jpwolfe31/Magnetic-Core-Memory-Demo-Board/Board back.JPG

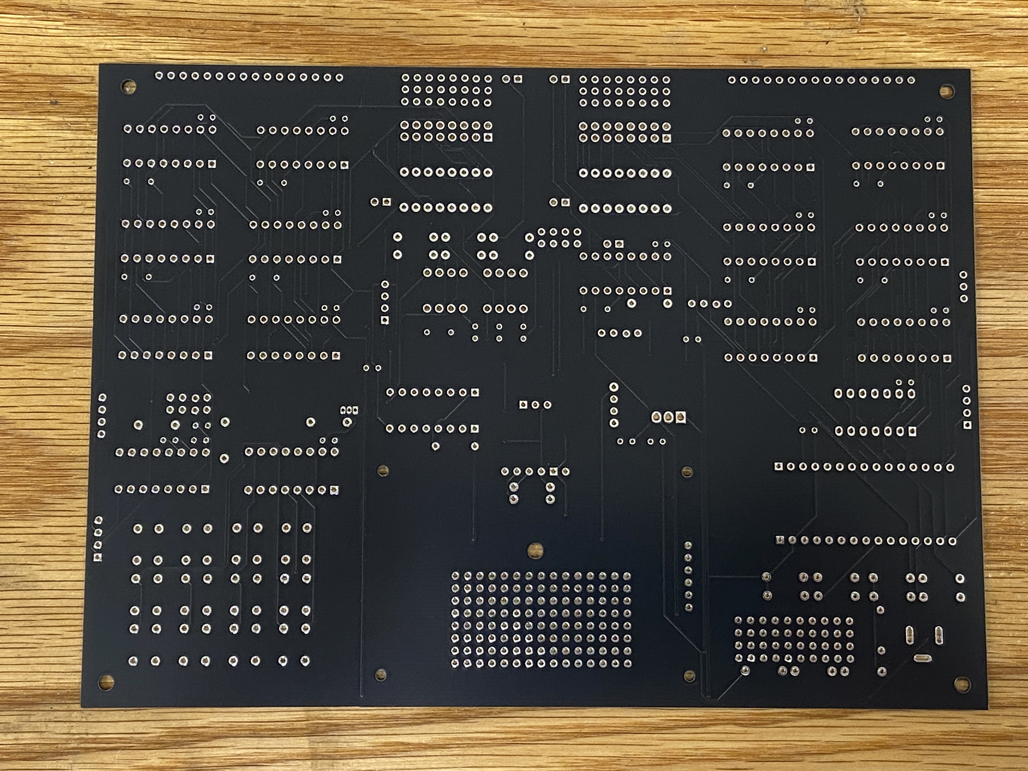
Board back.JPG
