jpwolfe31/Magnetic-Core-Memory-Demo-Board/Board front.JPG

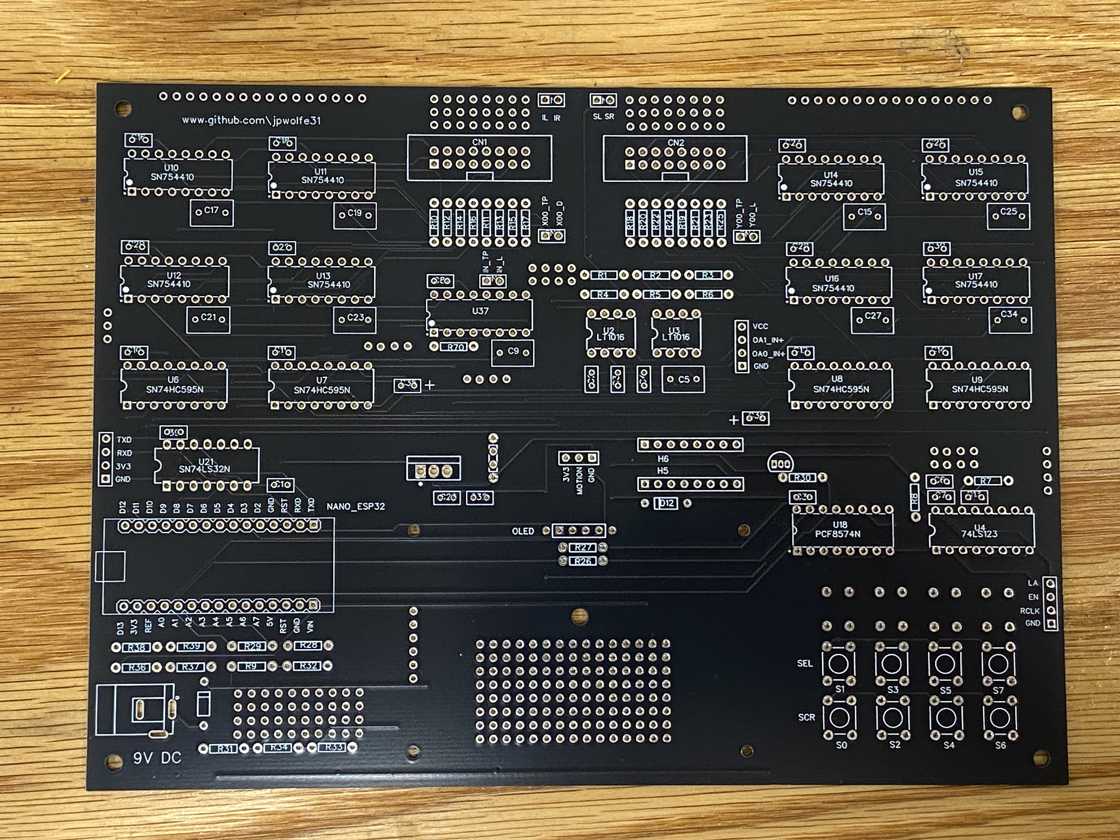
Board front.JPG
