jpwolfe31/Magnetic-Core-Memory-Demo-Board/Note on wrappin x drive lines.pdf

I looked into wrapping the x lines as shown below to reduce the number of x drive chips by one-half (x0 goes to x4, x1 goes to x5, etc.).

___________________________
___________________________
/ | \ | / | \ | / | \ | y1
\ | / | \ | / | \ | / | y0
x0 | x1 | x2 | x3 | x4 | x5 . . .
x0u | - | - | - | x4d
y0r | y0r | y0r | y0r | y0r
id | iu | id | iu | id

current directions at the cores:
r right
l left
u up
| d down

When a 1 is written to x0y0 as shown in the chart above, x4y1-7 will flip if the inhibit current equals the x4 current. Therefore, with the wrap, the inhibit current must be significantly less than the x current. I experimented with dierent current values, but could not achieve ultra reliable writes and reads, so I chose not to wrap the x lines. This choice was made easier once I had decided to limit the project to an 8 by 8 matrix of 64 bits.
