jpwolfe31/Magnetic-Core-Memory-Demo-Board/oscilloscope waveforms.pdf

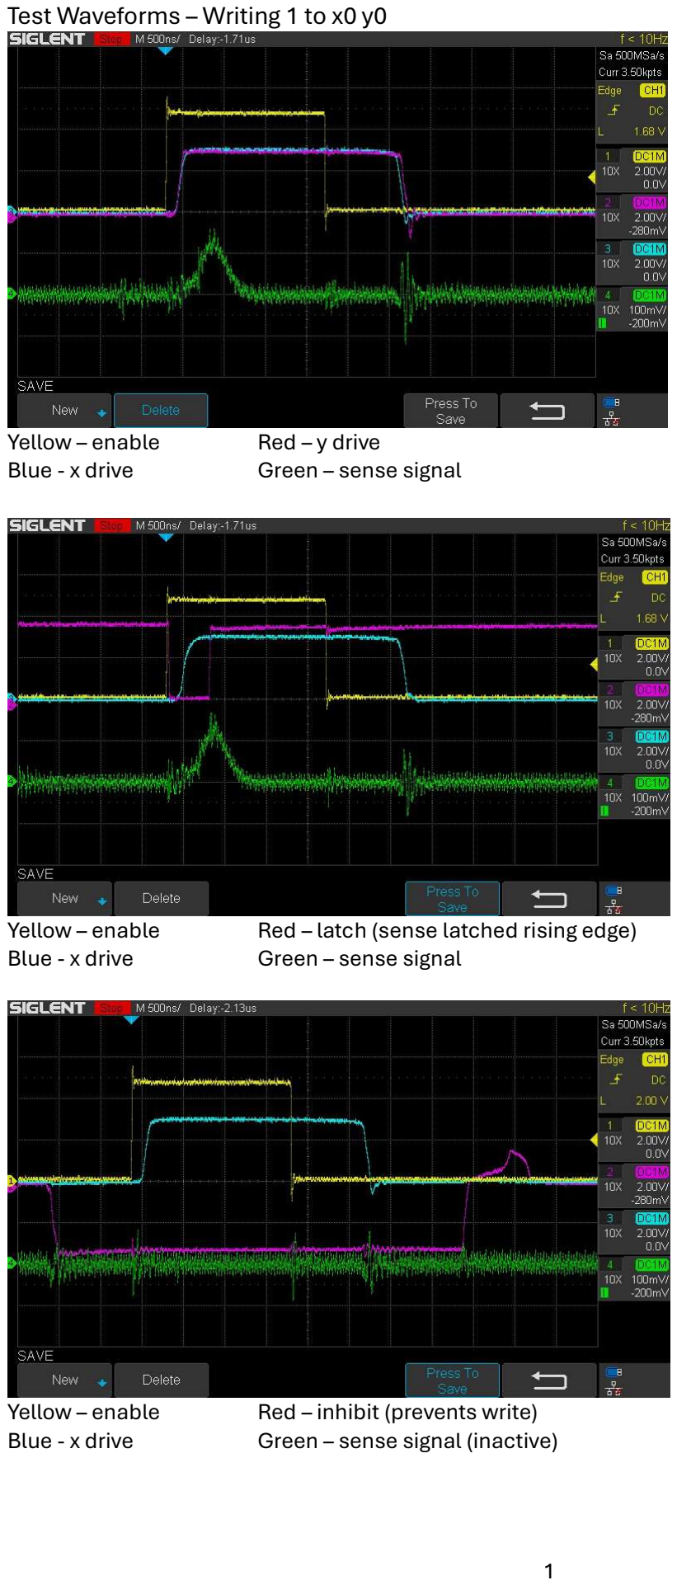
[picture p3: page 1]

1

Test Waveforms – Writing 1 to x0 y0

Yellow – enable | Red – y drive
Blue - x drive | Green – sense signal
Yellow – enable | Red – latch (sense latched rising edge)
Blue - x drive | Green – sense signal
Yellow – enable | Red – inhibit (prevents write)
Blue - x drive | Green – sense signal (inactive)

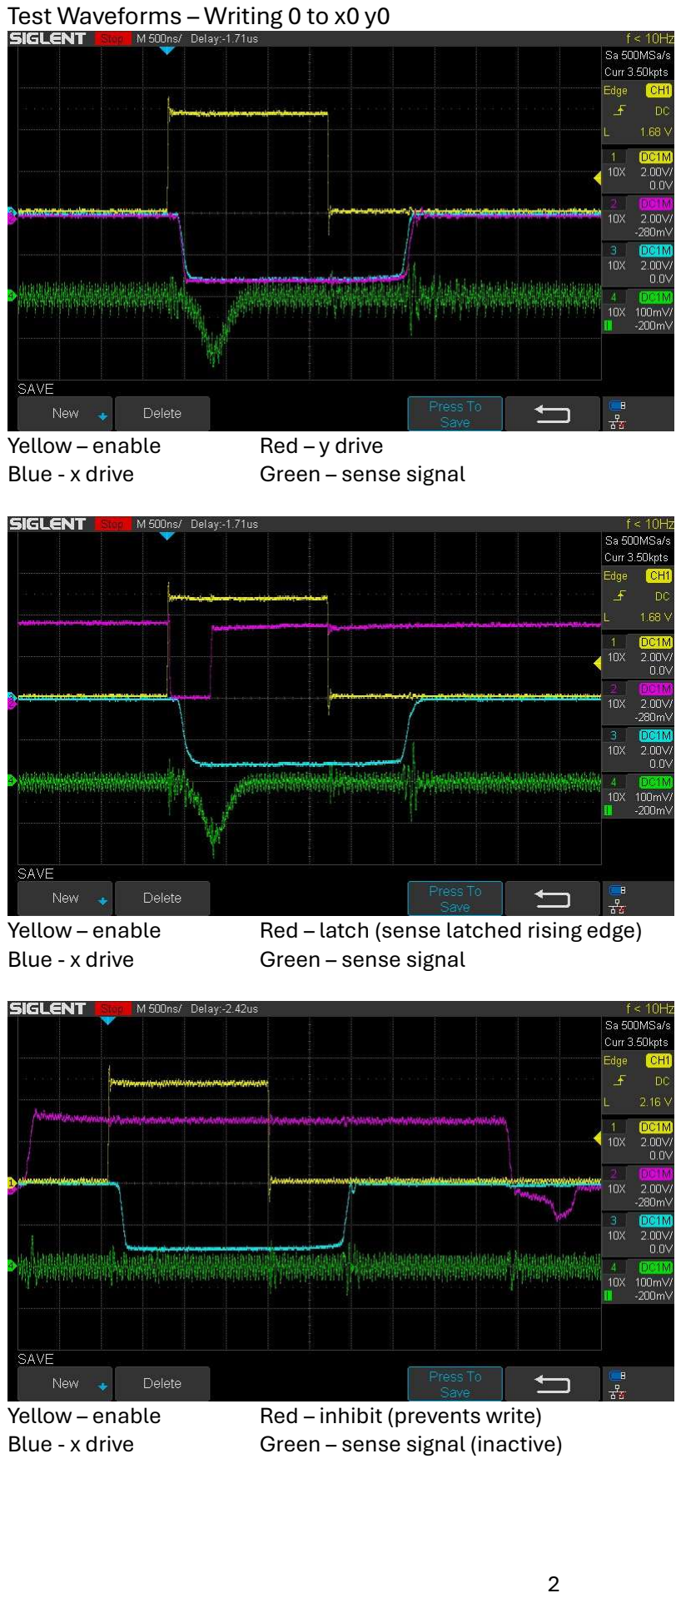
[picture p4: page 2]

2

Test Waveforms – Writing 0 to x0 y0

Yellow – enable | Red – y drive
Blue - x drive | Green – sense signal
Yellow – enable | Red – latch (sense latched rising edge)
Blue - x drive | Green – sense signal
Yellow – enable | Red – inhibit (prevents write)
Blue - x drive | Green – sense signal (inactive)

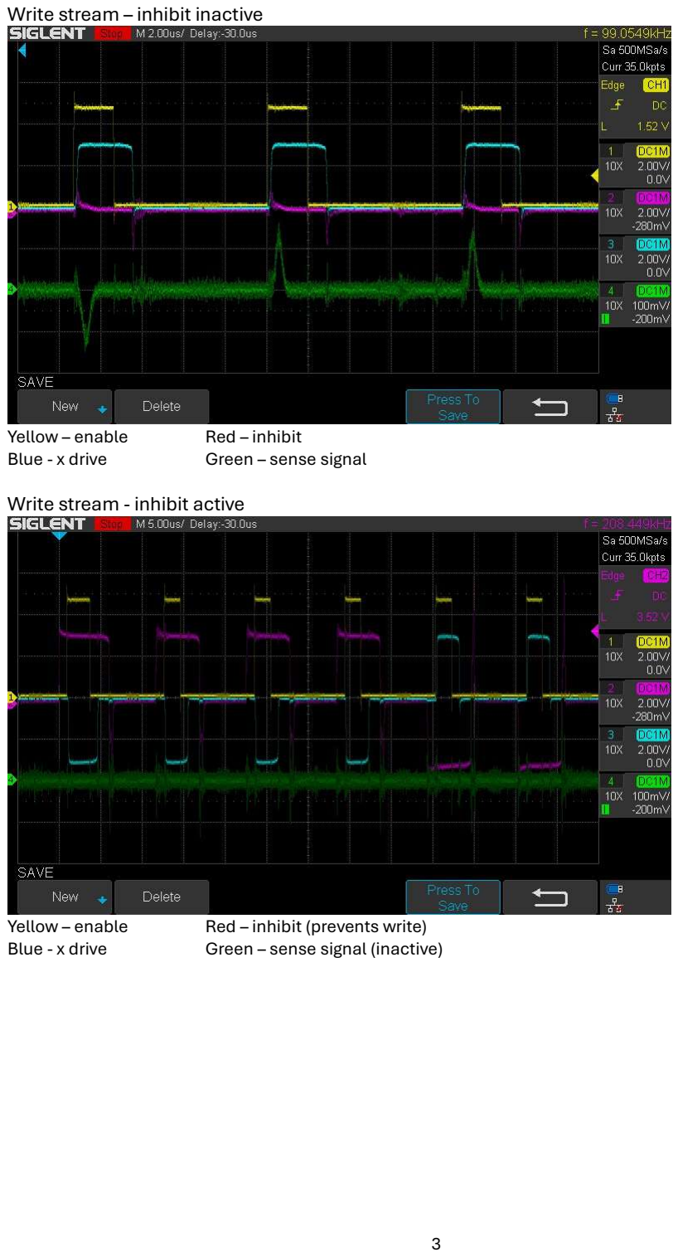
[picture p5: page 3]

3

Write stream – inhibit inactive

Yellow – enable | Red – inhibit
Blue - x drive | Green – sense signal

Write stream - inhibit active

Yellow – enable | Red – inhibit (prevents write)
Blue - x drive | Green – sense signal (inactive)
