jpwolfe31/Magnetic-Core-Memory-Demo-Board/10M count.JPG

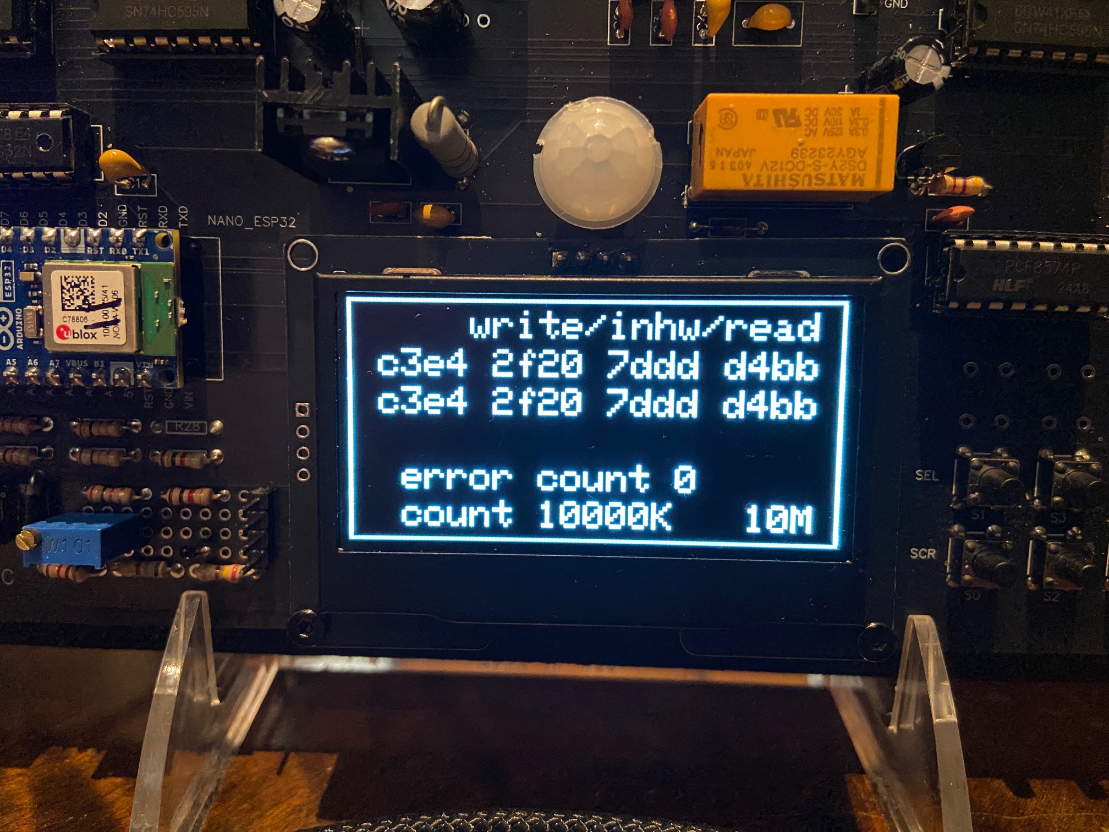
10M count.JPG
