jpwolfe31/Magnetic-Core-Memory-Demo-Board/Board adds.JPG

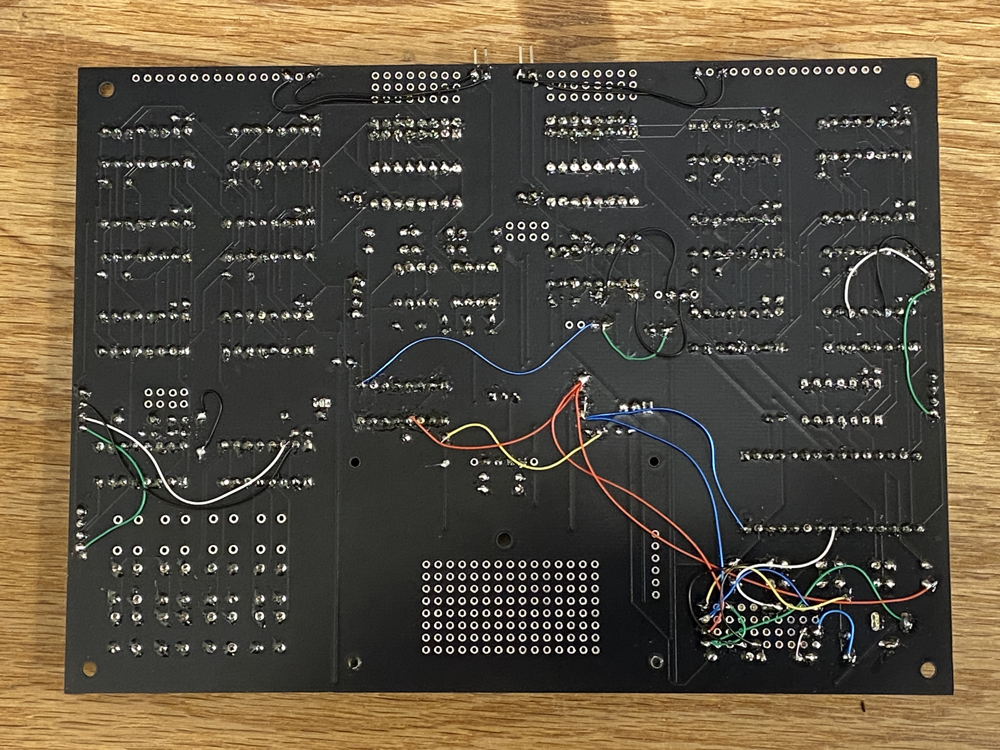
Board adds.JPG
