jpwolfe31/Magnetic-Core-Memory-Demo-Board/Board populated.JPG

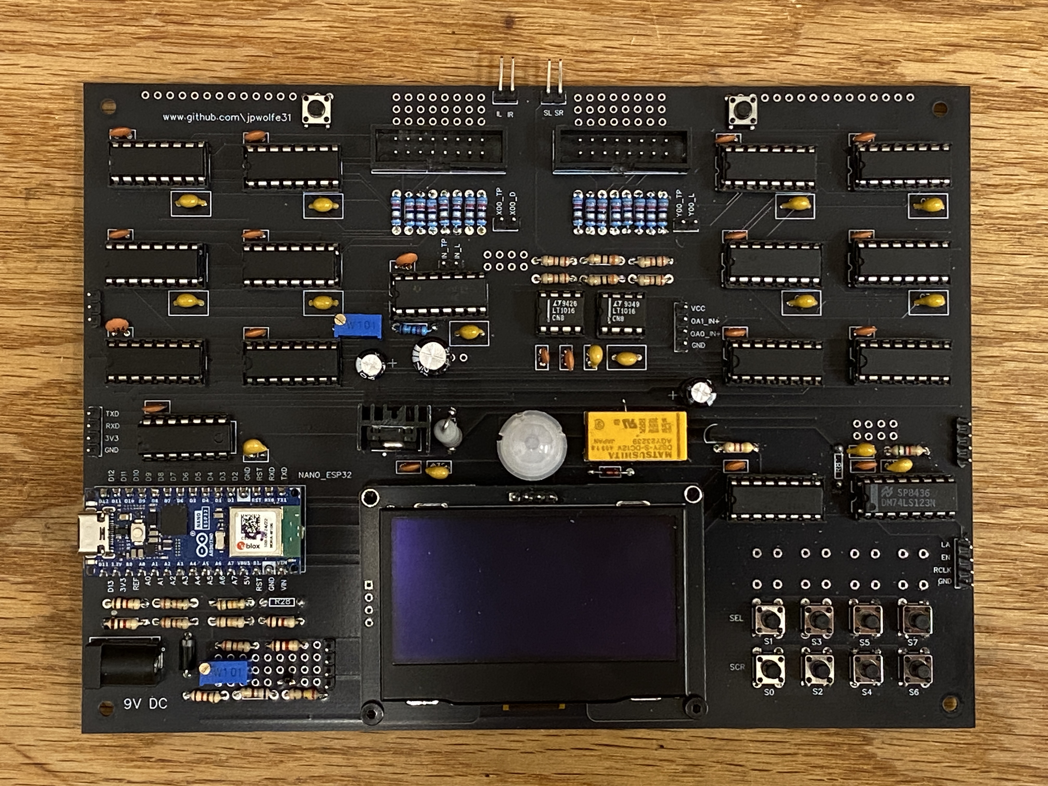
Board populated.JPG
