jpwolfe31/Magnetic-Core-Memory-Demo-Board/(commit log)

2026-02-24 Refactor README to improve clarity and remove duplicates
    Removed redundant final demo board section and adjusted formatting.
2026-02-26 Add magnetic core memory resource links to README
    Added links to resources about magnetic core memory.
2026-02-27 Revise README with power supply details and relay info
    Updated power supply issues and voltage settings for demo board operation. Added notes on relay usage for power reduction and feedback.
